flowing-wind/RISC-V_CPU/(commit log)

2025-12-10 add frame for Cocotb verification
2025-12-15 fix sh, sb, lh, lb, lbu, lhu
    [datapath.v]
2025-12-15 fix instr errors and complete sim CPU model & assembler, passed a simple verification!
    [cpu_model.py, dmem.v, test_top.py]
2025-12-19 fix assign order (output = ), add testbench, separate reset of clock and cpu
    [datapath.v, tb_riscv.v, top.v]
2025-12-19 fix pc sync with BRAM instr
    [datapath.v]
2025-12-22 BRAM ena use reset signal to control
    [top.v]
2025-12-22 fix control hazard caused by BRAM, add flushD logic
    [hazard_unit.v, processor_core.v]
2025-12-23 7-stage pipeline, fix lb error, try to control imem ena
    [datapath.v, hazard_unit.v, processor_core.v, tb_riscv.v, top.v]
2025-12-23 passed rv32ui tests, but do not support ma_data --> Misaligned Memory Access
    [tb_riscv.v]
2025-12-27 change to true dual BRAM, modify tcl, fix bug in ld_st test, del sim verilog files of imem, dmem and clk
    [tb_riscv.v, top.v]
2025-12-28 add UART, BUS structure, a bridge to convert AXI
2025-12-28 fix cpu_req trigger when not requiring mem
    [controller.v, datapath.v, hazard_unit.v, processor_core.v, top.v]
2025-12-28 fix Store-to-Load Hazard with lb lh sb sh
    [datapath.v]
2025-12-29 add a reg to is_uart_addr to prevent ReadData changing unexpectly
    [axi_bridge.v, hazard_unit.v, main.c, tb_riscv.v, top.v]
2025-12-29 UART test succeed
2025-12-29 add bootloader, FPGA loader remained to be fixed
    [hex2coe.py, main.c, tb_riscv.v, top.v]
2025-12-31 fix bugs in loading, add uart.c uart.h
    [main.c, top.v, uart.c, uart.h]
2026-01-04 add isp and user uart, modify uart.c .h, updata load logic
2026-01-04 fix axi bridge bugs
    [axi_bridge.v, tb_riscv.v, top.v]
2026-01-04 fix address misalignment with link.ld
    [hex2coe.py, main.c, tb_riscv.v, top.v, uart.c, uart.h]
2026-01-04 use old axi_bridge to solve UART
2026-01-05 update celluar auto, avoid using % (rem instr)
    [main.c]
